SushiBits/LKS32MC035-Hello/doc/minispin.pdf

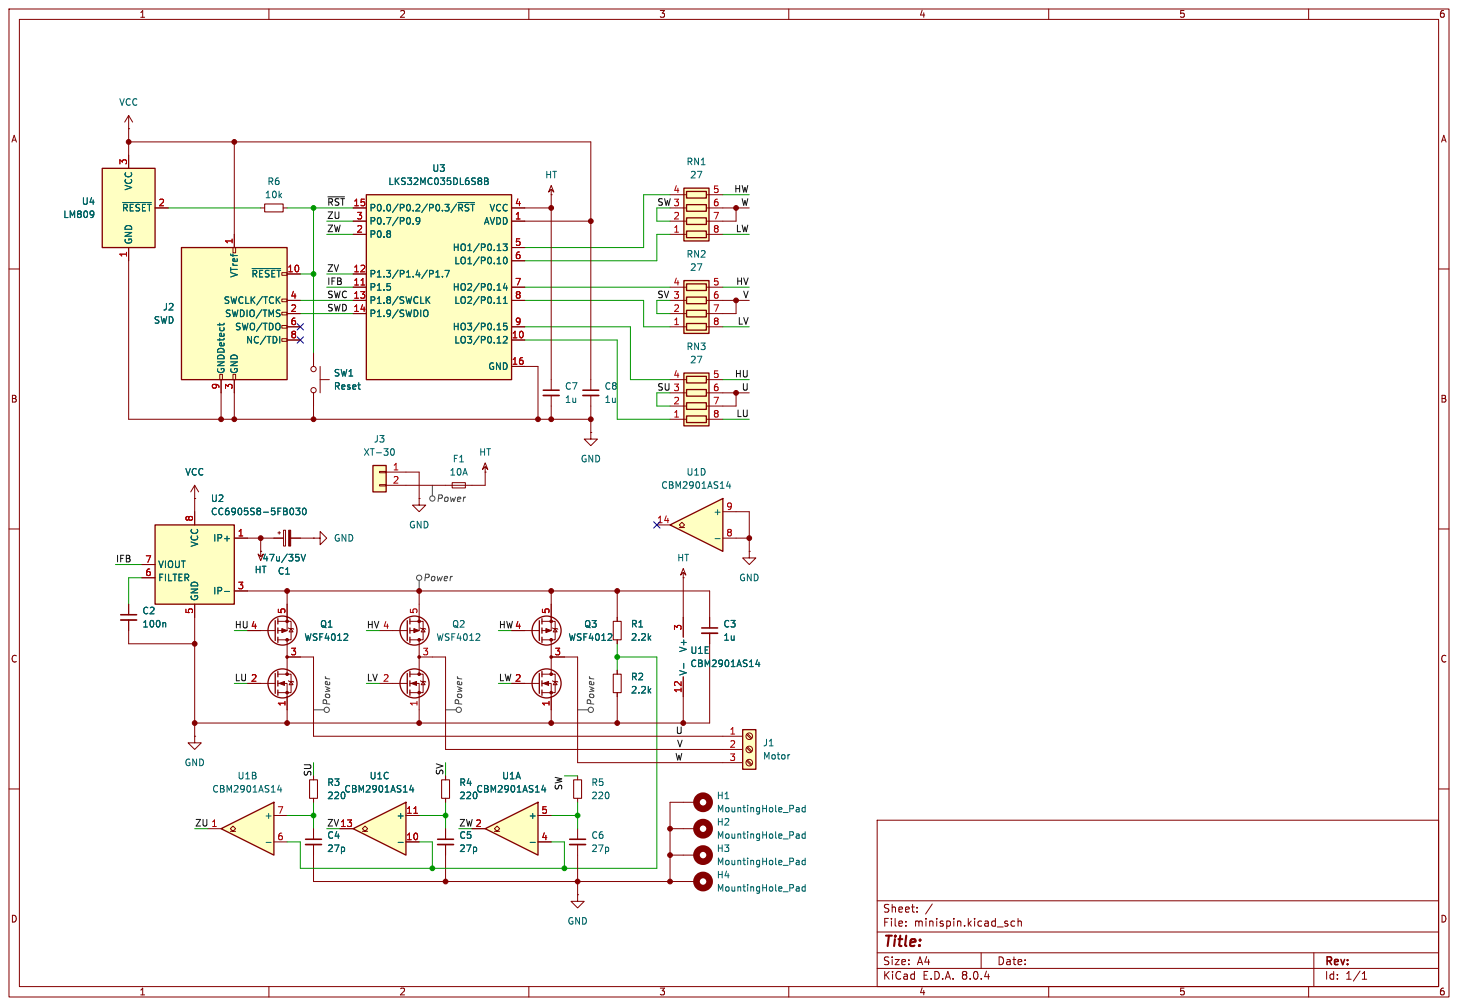
[picture p1: page 1]

Id: 1/1 Title: File: minispin.kicad_sch Sheet: / 123
