SushiBits/LKS32MC035-Hello/hardware/minispin.kicad_pcb

## KiCad design hardware/minispin.kicad_pcb (2026-11-01)

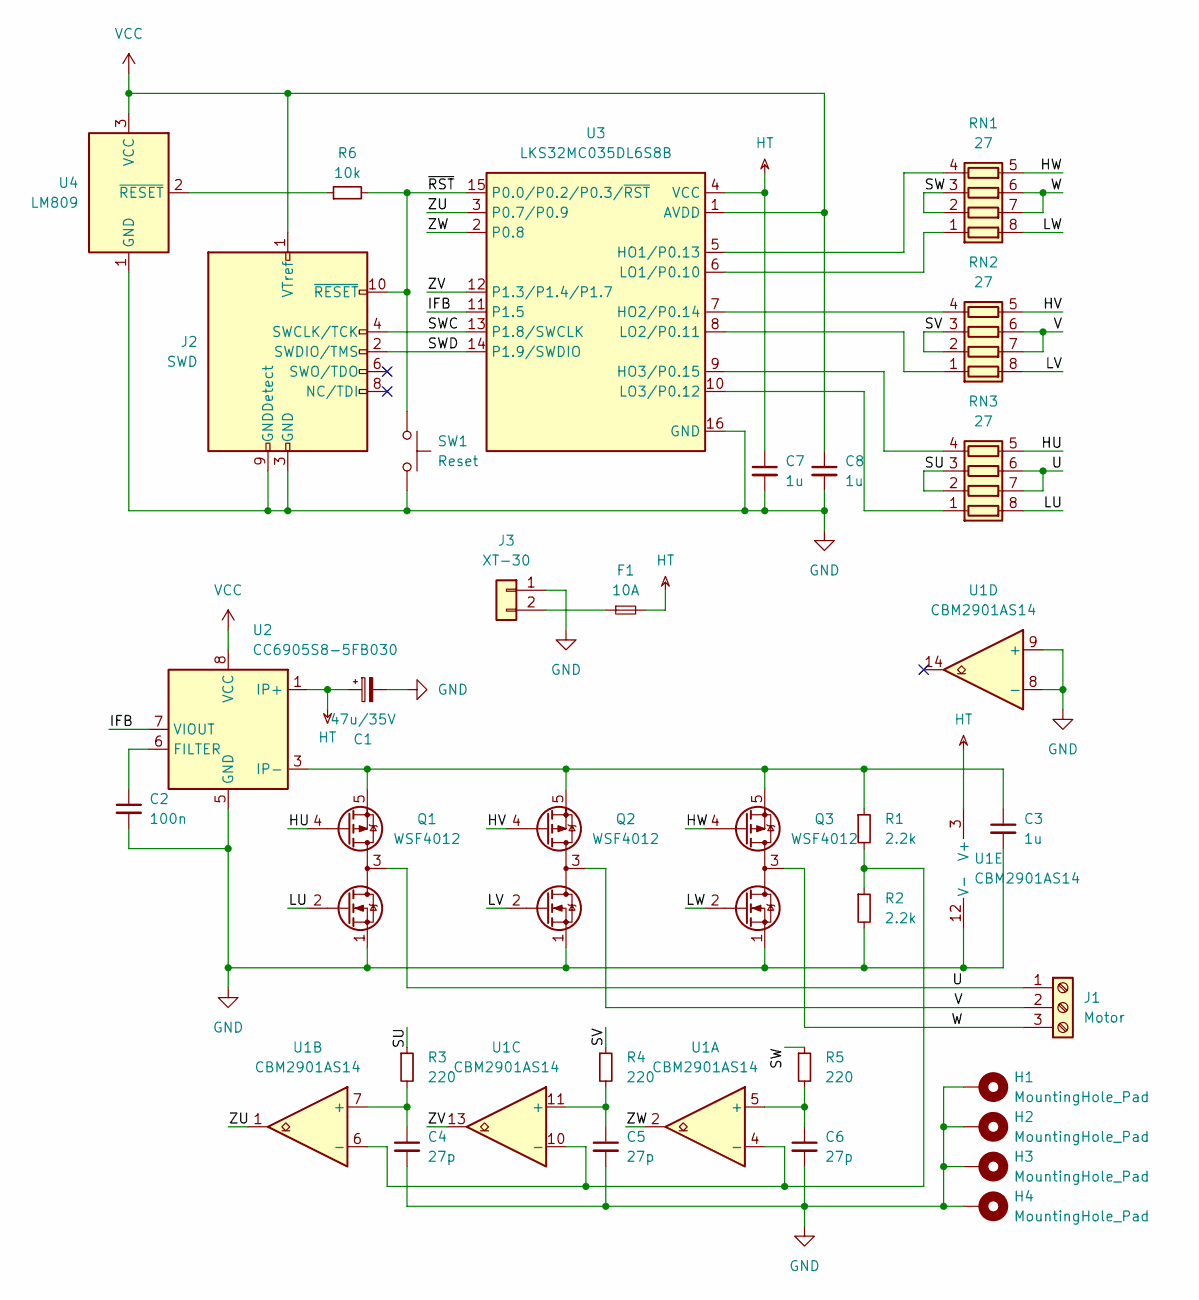
[picture p2: schematic minispin.kicad_sch]

Parts:
C1: 47u/35V; CP_EIA-7132-28_AVX-C
C2: 100n; C_0603_1608Metric_Pad1.08x0.95mm_HandSolder
C3, C7, C8: 1u; C_0603_1608Metric_Pad1.08x0.95mm_HandSolder
C4, C5, C6: 27p; C_0603_1608Metric_Pad1.08x0.95mm_HandSolder
F1: 10A; Fuseholder_Cylinder-5x20mm_Stelvio-Kontek_PTF78_Horizontal_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
H1, H2, H3, H4: MountingHole_Pad; MountingHole_3.2mm_M3_Pad_Via
J1: Motor; TerminalBlock_bornier-3_P5.08mm
J2: SWD; PinHeader_2x05_P1.27mm_Vertical
J3: XT-30; AMASS_XT30PW-M_1x02_P2.50mm_Horizontal
Q1, Q2, Q3: WSF4012; TO-252-4
R1, R2: 2.2k; R_0603_1608Metric_Pad0.98x0.95mm_HandSolder
R3, R4, R5: 220; R_0603_1608Metric_Pad0.98x0.95mm_HandSolder
R6: 10k; R_0603_1608Metric_Pad0.98x0.95mm_HandSolder
RN1, RN2, RN3: 27; R_Array_Convex_4x0603
SW1: Reset; SW_SPST_EVQP2
U1: CBM2901AS14; SOIC-14_3.9x8.7mm_P1.27mm
U2: CC6905S8-5FB030; SOIC-8_3.9x4.9mm_P1.27mm
U3: LKS32MC035DL6S8B; SO-16_3.9x9.9mm_P1.27mm
U4: LM809; SOT-23

Connections:
/HU: Q1.4 (G1), RN3.5 (R4.2)
/HV: Q2.4 (G1), RN2.5 (R4.2)
/HW: Q3.4 (G1), RN1.5 (R4.2)
/IFB: U2.7 (VIOUT), U3.11 (P1.5)
/LU: Q1.2 (G2), RN3.8 (R1.2)
/LV: Q2.2 (G2), RN2.8 (R1.2)
/LW: Q3.2 (G2), RN1.8 (R1.2)
/SU: R3.1, RN3.2 (R2.1), RN3.3 (R3.1)
/SV: R4.1, RN2.2 (R2.1), RN2.3 (R3.1)
/SW: R5.1, RN1.2 (R2.1), RN1.3 (R3.1)
/SWC: J2.4 (SWCLK/TCK), U3.13 (P1.8/SWCLK)
/SWD: J2.2 (SWDIO/TMS), U3.14 (P1.9/SWDIO)
/U: J1.1, Q1.3 (S1/D2), RN3.6 (R3.2), RN3.7 (R2.2)
/V: J1.2, Q2.3 (S1/D2), RN2.6 (R3.2), RN2.7 (R2.2)
/W: J1.3, Q3.3 (S1/D2), RN1.6 (R3.2), RN1.7 (R2.2)
/ZU: U1.1, U3.3 (P0.7/P0.9)
/ZV: U1.13, U3.12 (P1.3/P1.4/P1.7)
/ZW: U1.2, U3.2 (P0.8)
/~RST: J2.10 (~RESET), R6.2, SW1.1, U3.15 (P0.0/P0.2/P0.3/~RST)
GND: C1.2, C2.2, C3.2, C4.2, C5.2, C6.2, C7.2, C8.2, H1.1, H2.1, H3.1, H4.1, J2.3 (GND), J2.5 (GND), J2.9 (GNDDetect), J3.1, Q1.1 (S2), Q2.1 (S2), Q3.1 (S2), R2.2, SW1.2, U1.8 (-), U1.9 (+), U1.12 (V-), U2.5 (GND), U3.16 (GND), U4.1 (GND)
HT: C1.1, C7.1, F1.2, U1.3 (V+), U2.1 (IP+), U2.2 (IP+), U3.4 (VCC)
unnamed: F1.1, J3.2
unnamed: C3.1, Q1.5 (D1), Q2.5 (D1), Q3.5 (D1), R1.1, U2.3 (IP-), U2.4 (IP-)
unnamed: RN1.1 (R1.1), U3.6 (LO1/P0.10)
unnamed: RN1.4 (R4.1), U3.5 (HO1/P0.13)
unnamed: RN2.1 (R1.1), U3.8 (LO2/P0.11)
unnamed: RN2.4 (R4.1), U3.7 (HO2/P0.14)
unnamed: RN3.1 (R1.1), U3.10 (LO3/P0.12)
unnamed: RN3.4 (R4.1), U3.9 (HO3/P0.15)
unnamed: C6.1, R5.2, U1.5 (+)
unnamed: R1.2, R2.1, U1.4 (-), U1.6 (-), U1.10 (-)
unnamed: C4.1, R3.2, U1.7 (+)
unnamed: C5.1, R4.2, U1.11 (+)
unnamed: C2.1, U2.6 (FILTER)
unnamed: R6.1, U4.2 (~RESET)
VCC: C8.1, J2.1 (VTref), U2.8 (VCC), U3.1 (AVDD), U4.3 (VCC)

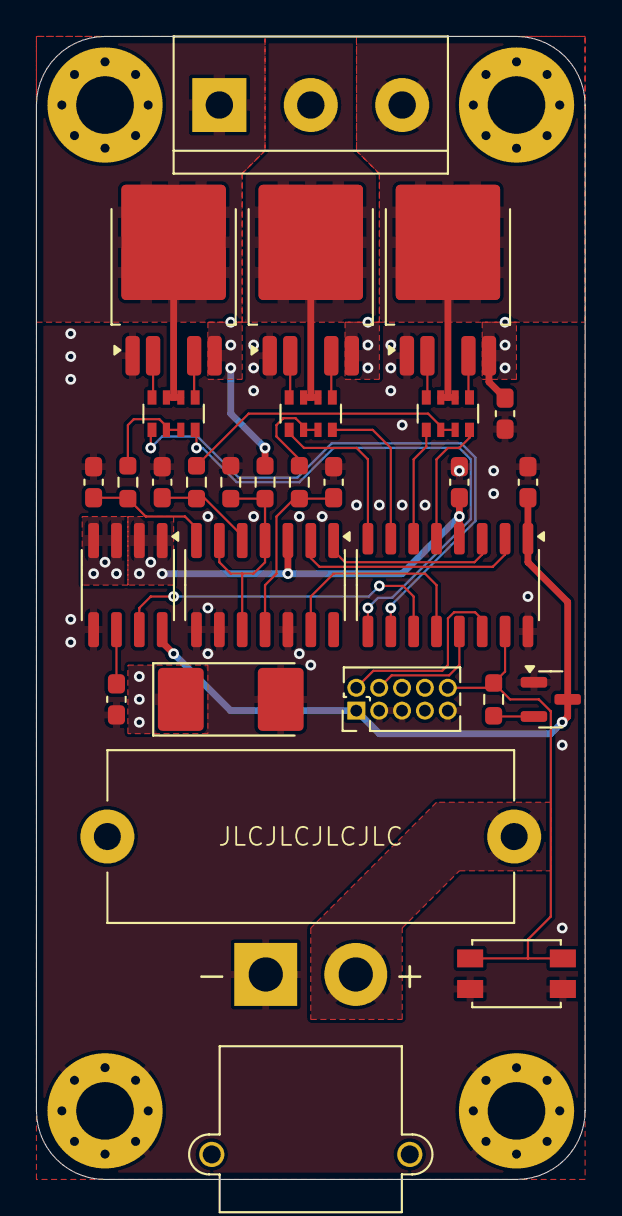
[picture p3: board minispin.kicad_pcb from above]

Board: 2 copper layers, 30.5 x 63.5 mm, 33 parts (0 on the bottom side), 36 nets.
