SushiBits/LKS32MC035-Hello/(commit log)

2026-11-01 Start a repository for a chip the vendor would rather you used a library for.
    Two files: a .gitignore assembled from every other project I own, and a README
    making a claim that cannot be tested from inside the repository - "likely the
    first ever LKS32MD03x project written without vendor library".
    No code. No build system. No hint that the watchdog is armed at reset, that the
    vendor's own SVD contradicts the vendor's own RM, or that establishing either
    fact will consume the better part of a week.
2026-11-01 Commit the hardware before the firmware, so the firmware has something to be wrong about.
    24,845 lines of KiCad: a schematic, a board and a project file. The schematic is
    the only real specification this project will ever have, which is exactly why it
    lives as three text blobs in a firmware repository instead of somewhere a
    firmware person might look for it.
    [minispin.kicad_pcb, minispin.kicad_sch]
2026-11-02 Add the schematics as a PDF, because a schematic nobody can diff is a schematic nobody can regress.
    Zero insertions, zero deletions, one file. Git will store it faithfully for a
    decade and be able to tell me nothing about it - which is more or less the
    relationship this project has with its own vendor documentation.
2026-11-02 Import the vendor SVD, which is structural, machine-checkable, and wrong.
    12,554 lines of register truth plus the schema it claims to satisfy. It passes
    every automated check we own. It also says the watchdog is disabled at reset
    when it is enabled, describes two adjacent power-down bits in one register using
    opposite polarity conventions, and omits the bit that governs whether the HRC
    can ever be shut off.
    Nothing in this repository can detect any of that. The detector is a scope, a
    debugger and time - and the debugger turns out to be gated behind the watchdog,
    which is gated behind the SVD being wrong.
2026-11-02 Build it with make, because somebody else's IDE is somebody else's problem.
    A Makefile that compiles a few .c files, links against a linker script that
    does not exist yet, and generates the register header by shelling out to
    C:\Keil_v5\UV4\SVDConv.exe - a hardcoded path to a Windows-only binary, behind a
    leading dash, so that when it fails - and it will - make carries on cheerfully.
    irqn.sh turns interrupt names into vector entries and demands bash on Windows to
    do it. That is not a bug, it is a lifestyle.
2026-11-02 We have a debuggable build now. We do not yet have a build that stays debugged.
    Startup code in C, a linker script that copies the vector table into IRAM
    because it is faster there, VS Code plumbing, and the platform headers. The
    .gitignore learns to exclude the generated headers, which is the best decision
    in this commit and is not up for debate.
    Nothing here knows that the IWDG has been counting since the reset pin went
    high, or that "debuggable" is therefore a claim with an expiration date measured
    in milliseconds.
2026-11-02 "main"
    The most forthcoming commit message in the repository.
    Adds src/main.c, an empty SystemInit, an empty SystemCoreClockUpdate, and the
    glue from reset to _start. main() waits for an event forever. SystemInit()
    deliberately does nothing, so the core runs at whatever reset left it at: per
    the SVD that is HRC divided by 8, i.e. 500kHz, and nobody has noticed yet.
    Commit message quality: declining.
    [main.c]
2026-11-04 Add notes to the startup files. Also, the watchdog.
    The notes are why this commit matters in hindsight. The IWDG is enabled at reset
    with or without a debugger attached, it resets the device mid-session, and in
    that state only a system reset can get the device to connect to a debugger
    again. That last sentence is the most valuable thing anyone has written in this
    repository, and it lives three lines above a magic hex constant in a comment
    block in a system file.
    Also here: the SYS protect unlock, the IWDG kill shot, and debug-in-sleep. And
    the observation that this harks of the TI MSP430 CPU16 series, which is true and
    is why it is included.
    Retroactively: this is the commit where the week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
2026-11-04 Adding debugging facilities.
    The J-Link script added here is not a convenience. The IWDG is armed at reset
    by the always-on domain, and the generated header states the opposite:
    IWDG_CFG.WDG_EN has resetValue 0 and is documented as "IWDG is disabled".
    That is wrong, and believing it is expensive. An armed IWDG resets the core
    during the attach sequence, so the target drops out mid-session without ever
    saying why. Everything else on the list then looks guilty - SWD wiring, reset
    type and reset pin, clock configuration, VTOR relocation, sleep modes. None of
    them are the cause. Establishing this cost about a week.
    The RM's version is the one that matches silicon, and it carries three rules
    the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
    [main.c]
2026-11-04 Admit in the register map that the watchdog was never asleep.
    The vendor's own SVD and the vendor's own RM have been arguing in public for
    this project's entire lifetime. The SVD said IWDG_CFG resets to 0x0000 with
    WDG_EN clear - "IWDG is disabled". The RM said 默认使能, enabled by default,
    and the silicon, which is the only one of the three with a vote, sided with
    the RM. Believing the machine-readable document cost somebody a week. That is
    the going rate for a false premise, and the register map supplied one in the
    exact place you consult when the debugger will not attach.
    So CFG resets to 0x0001. The upper byte is DISABLE_KEY: write-only, 0x3C,
    and not a setting - a token that means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
    [main.c]
2026-11-04 Pin the oracle. Both of them. All 17MB of them.
    Until now every claim in this repository appealed to two PDFs that lived on one
    machine and were generously assumed to be in the reader's possession. Now they
    are in the tree, which upgrades "the RM says 默认使能" from a citation you cannot
    check into one you can.
    That matters more than the code does. The SVD and the RM disagree about whether
    the watchdog is armed at reset, about the polarity conventions inside AFE_REG0,
    and about whether a bit governing the HRC exists at all. Two of the three
    documents involved are now here and citable by revision. The third has been here
    since the fifth commit and is the one that lies.
    Pinned so future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
2026-11-04 Say who owns what, and finally mean it.
    This repository has been public since the day it was created and has had no
    licence for any of it. Now there is a LICENSE.md - 3-clause BSD, in the name of
    HIKARU Infotech Shanghai Ltd. - covering the firmware and the KiCad source, and
    the README can use the word "open-source" as a licence grant rather than as a
    boast.
    The new Copyright section is really a territory map:
    firmware + hardware BSD-3-Clause, mine
    doc/LKS32MC03x*.pdf + SVD Linko's, "with my edits"
    cmsis/ Arm's, see its own LICENSE
    The second line is the honest one and the uncomfortable one. The SVD in this
    repository is a derived work: it now ca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
2026-11-04 Explain the one line the generated header cannot.
    Fourteen lines of comment over one line of code is usually a smell. Here it is
    the only container the constraint fits in: disarming the IWDG requires WDG_EN
    = 0 and the 0x3C key inside the same bus write, and CMSIS-SVD has no way to say
    "these two must travel together". The header can name both halves. The
    relationship between them is prose or it is nothing.
    So the prose now says the thing that matters, in the form somebody will be
    reading at two in the morning with a debugger that will not attach:
    * this must be a straight assignment, not |=
    * |= against an armed watchdog leaves it armed and looking disarmed
    * the symptom of getting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
2026-11-04 Delete GPIO1, keep GPIO1.
    The vendor's SVD declares GPIO0 and GPIO1 as two complete, independent
    peripherals: the same seven registers, described twice, differing only in the
    strings "GPIO0" and "GPIO1", which had been baked into every field description
    ("GPIO0[n] input enable", "GPIO0[n] pull-up enable", and so on, twice per port).
    The result is two identical structs, two macro families, and two places to fix
    everything forever. SVDConv did exactly what it was told.
    CMSIS-SVD has had derivedFrom and headerStructName this entire time. GPIO1 is
    now five lines and inherits the lot; GPIO0 names the shared struct GPIO_Type;
    408 lines leave the file and 59 arrive, and the only GPIO1_* symbols l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
    [gpio.c, gpio.h, main.c]
2026-11-06 Get the object files out of the source tree, finally.
    Since the build system existed, .o and .d files have been landing next to the .c
    files that produced them - src/main.c.o, platform/src/system_LKS32MC03x.c.o, and
    the .d files beside those, all invisible to .gitignore until now. Building was a
    slow act of defacement: run make, then run git status to find out what happened
    to your working tree. Except you could not, because .gitignore covered *.o but
    not *.d, so the dependency files were permanently untracked and the object files
    were the only honest signal that a build had occurred.
    Everything now goes to .build/, mirroring the source layout, created on demand
    by mkdir -p in each pattern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
2026-11-06 Fill in the blanks with 0x67 and hope the RM remembers.
    GPIO comes up: pull-ups and input enable on P0.7, P0.8 and P1.4 for the
    zero-crossing comparators, both-edge triggers on their EXTI lines, and the six
    MCPWM pins configured with a defined level before they are switched to outputs
    so the gate drivers never see a glitch.
    The register map helped with all of that and knew the answer to almost none of
    it. Three registers demonstrate the difference:
    * MCPWM->SWAP. The SVD has the register. Its description is "MCPWM channel
    swap". It has no fields at all - not one - so 0x67 is a number with no
    decomposition available, and the only place it is documented is a page of
    the RM that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
    [gpio.c, main.c]
2026-11-06 Call the function-select registers what they are, and give the bits names.
    Three things, all in the same direction: replace a number with a word.
    EXTI.CR0 and CR1 gain the enumerated values they never had - NONE, FALLING,
    RISING, BOTH - so 0b11 becomes EXTI_CR0_T5_BOTH and the code stops containing a
    comment explaining why it wrote a three. 428 of this file's INFO messages are
    "field has no enumerated values"; these were four of the cheap ones. The
    encoding is the obvious one (00 nothing, 01 falling, 10 rising, 11 both) and is
    the one thing in this commit that still wants a scope on it.
    MCPWM.SWAP stops being an empty register. It was described "MCPWM channel swap"
    with zero fields, so 0x6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
    [gpio.c]
2026-11-06 Unlock MCPWM before writing to it, which the last commit did not.
    MCPWM.PRT was the second write-only register in this file described only as
    "Write 0xDEAD to unlock Protect" with no fields, so 0xDEAD was a comment rather
    than a symbol. It is now a field: KEY, [15:0], one enumerated value 0xDEAD,
    which SVDConv renders as MCPWM_PRT_KEY_KEY = 57005. Not a word. Still greppable.
    Which raises the question of what the previous commit actually accomplished.
    SWAP was written without touching PRT, and PRT gates MCPWM register writes, so
    that store almost certainly landed on a locked register and was discarded. A
    locked register still accepts the bus transaction; it just does not keep it. The
    "verif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
    [gpio.c]
2026-11-06 Give the motor a tachometer, and admit the tachometer needs a clock.
    systick.c is now a complete module: SysTick interrupts every millisecond,
    ms_counter counts them, millis() reports them, micros() adds the fraction of
    the current tick read back out of the SysTick down-counter, and delay() and
    delay_us() wait on both. main() calls systick_init() before gpio_init(),
    because a timebase is only useful if it exists before the first thing that
    wants to measure something.
    micros() is obviously the tachometer. A six-step controller measures speed by
    timing the gap between commutation events, so the resolution of this function
    is the resolution of the speed reading. At 20,000 RPM with three events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
